JQIamo/LongTermTempMon/LongTermTempMon_4ch.brd

## EAGLE design LongTermTempMon_4ch.brd (2015-11-16)

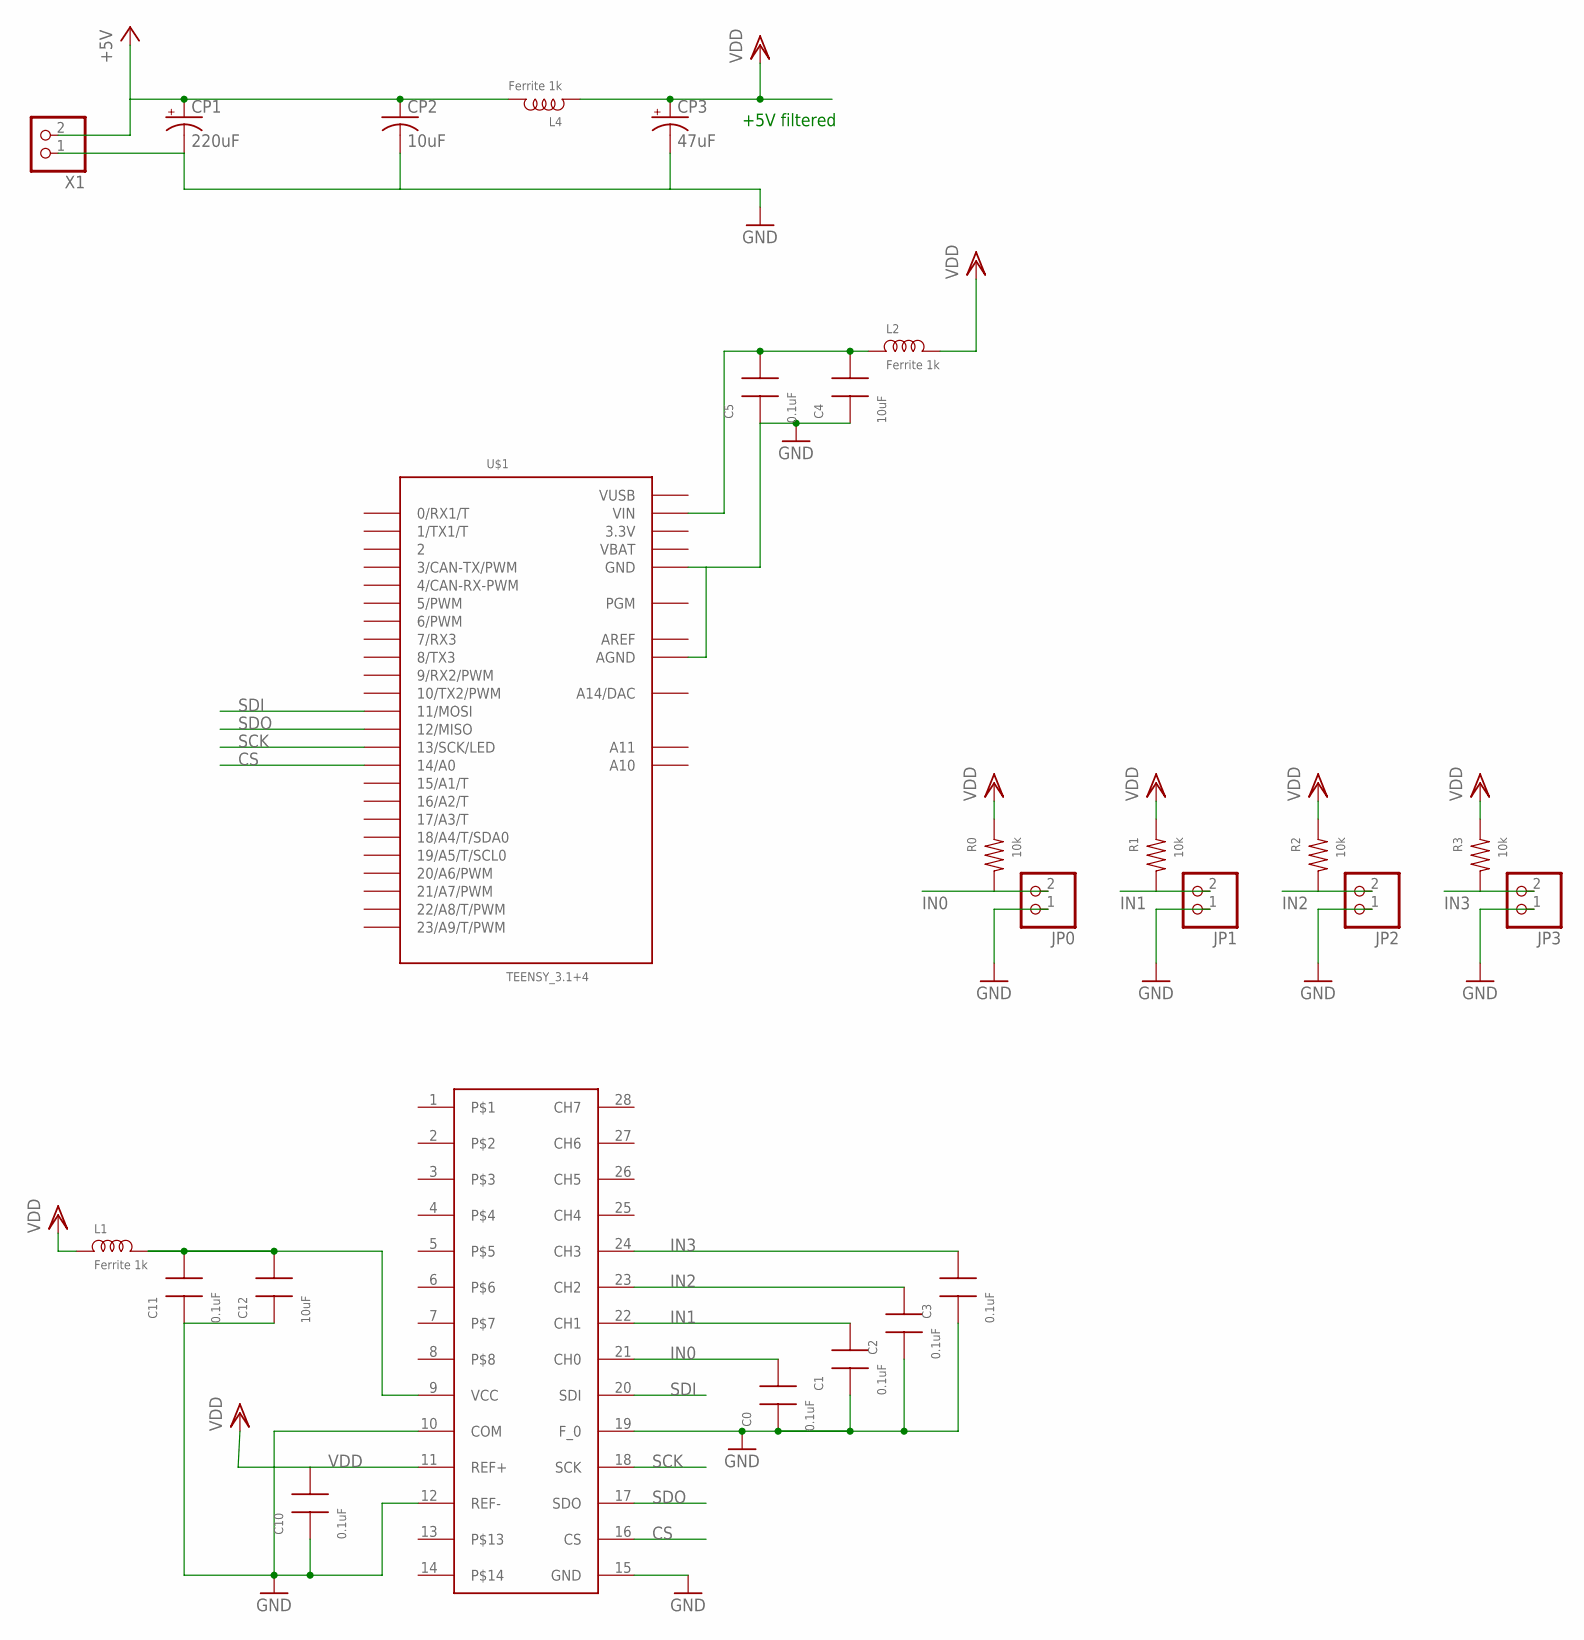
[picture p1: schematic LongTermTempMon_4ch.sch]

Parts:
C0, C1, C2, C3, C5, C10, C11: 0.1uF; 0603
C4, C12: 10uF; 0805
CP1: 220uF; PANASONIC_F
CP2: 10uF; C0805K
CP3: 47uF; CT7343
IC2: LTC2418; SSOP28
JP0, JP1, JP2, JP3: SCRWTRM-1X2; 1X02_SCRWTRM
L1, L2, L4: Ferrite 1k; 0805
R0, R1, R2, R3: 10k; 1206
U$1: TEENSY_3.1+4
X1: SCRWTRM-1X2; 1X02_SCRWTRM

Connections:
3.3V: U$1.3.3V, U$1.3.3V1 (3.3V)
+5V: CP1.+, CP2.1, L4.2, X1.2
AREF: U$1.AREF
CS: IC2.16 (CS), U$1.14/A0
GND: C0.1, C1.1, C2.1, C3.1, C4.1, C5.1, C10.1, C11.1, C12.1, CP1.-, CP2.2, CP3.-, IC2.10 (COM), IC2.12 (REF-), IC2.15 (GND), IC2.19 (F_0), JP0.1, JP1.1, JP2.1, JP3.1, U$1.AGND, U$1.GND, U$1.GND1 (GND), X1.1
IN0: C0.2, IC2.21 (CH0), JP0.2, R0.2
IN1: C1.2, IC2.22 (CH1), JP1.2, R1.2
IN2: C2.2, IC2.23 (CH2), JP2.2, R2.2
IN3: C3.2, IC2.24 (CH3), JP3.2, R3.2
unnamed: C11.2, C12.2, IC2.9 (VCC), L1.2
unnamed: C4.2, C5.2, L2.1, U$1.VIN
SCK: IC2.18 (SCK), U$1.13 (13/SCK/LED)
SDI: IC2.20 (SDI), U$1.11 (11/MOSI)
SDO: IC2.17 (SDO), U$1.12 (12/MISO)
VBAT: U$1.VBAT
VDD: C10.2, CP3.+, IC2.11 (REF+), L1.1, L2.2, L4.1, R0.1, R1.1, R2.1, R3.1
VUSB: U$1.VUSB

Notes on the sheet:
+5V filtered

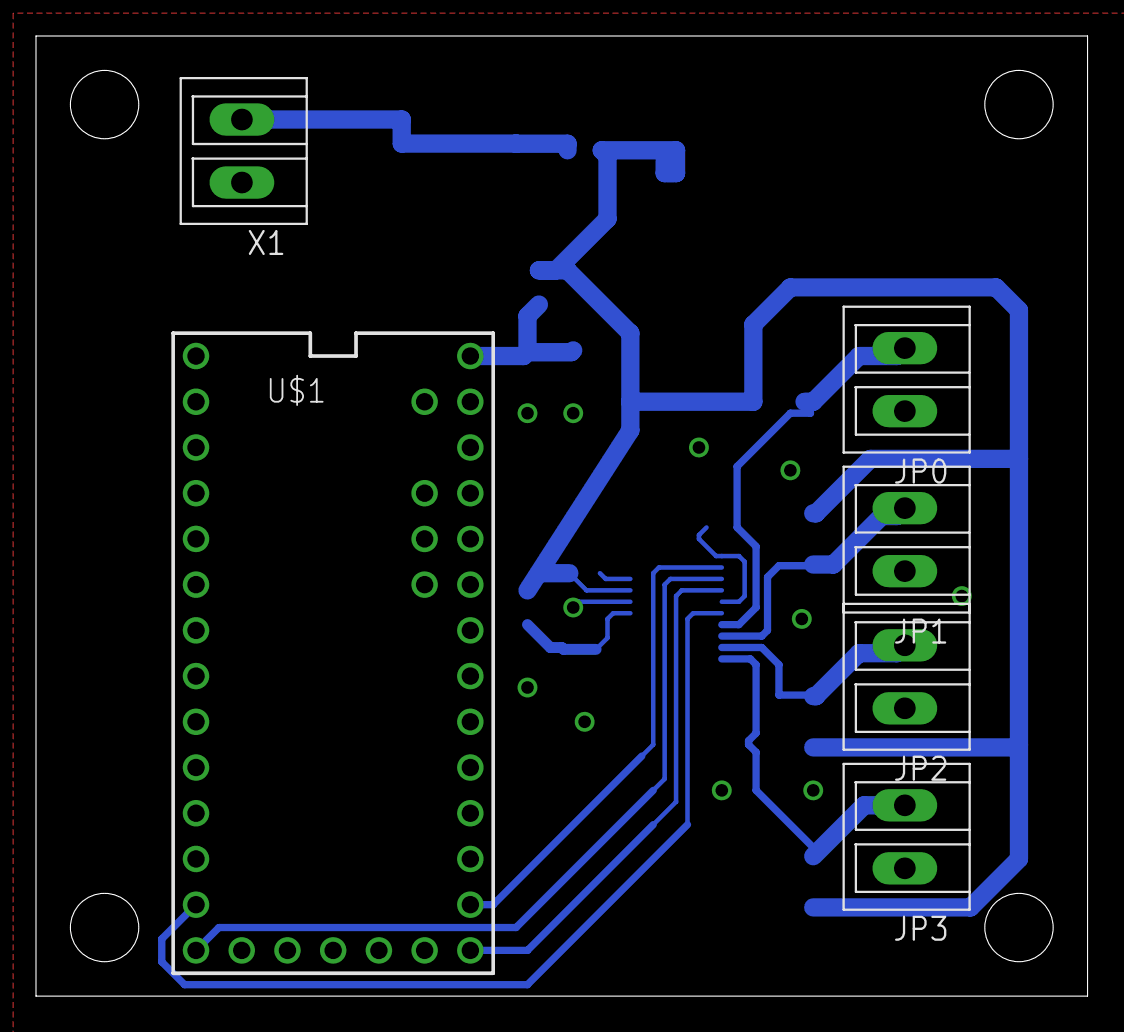
[picture p2: board LongTermTempMon_4ch.brd from above]

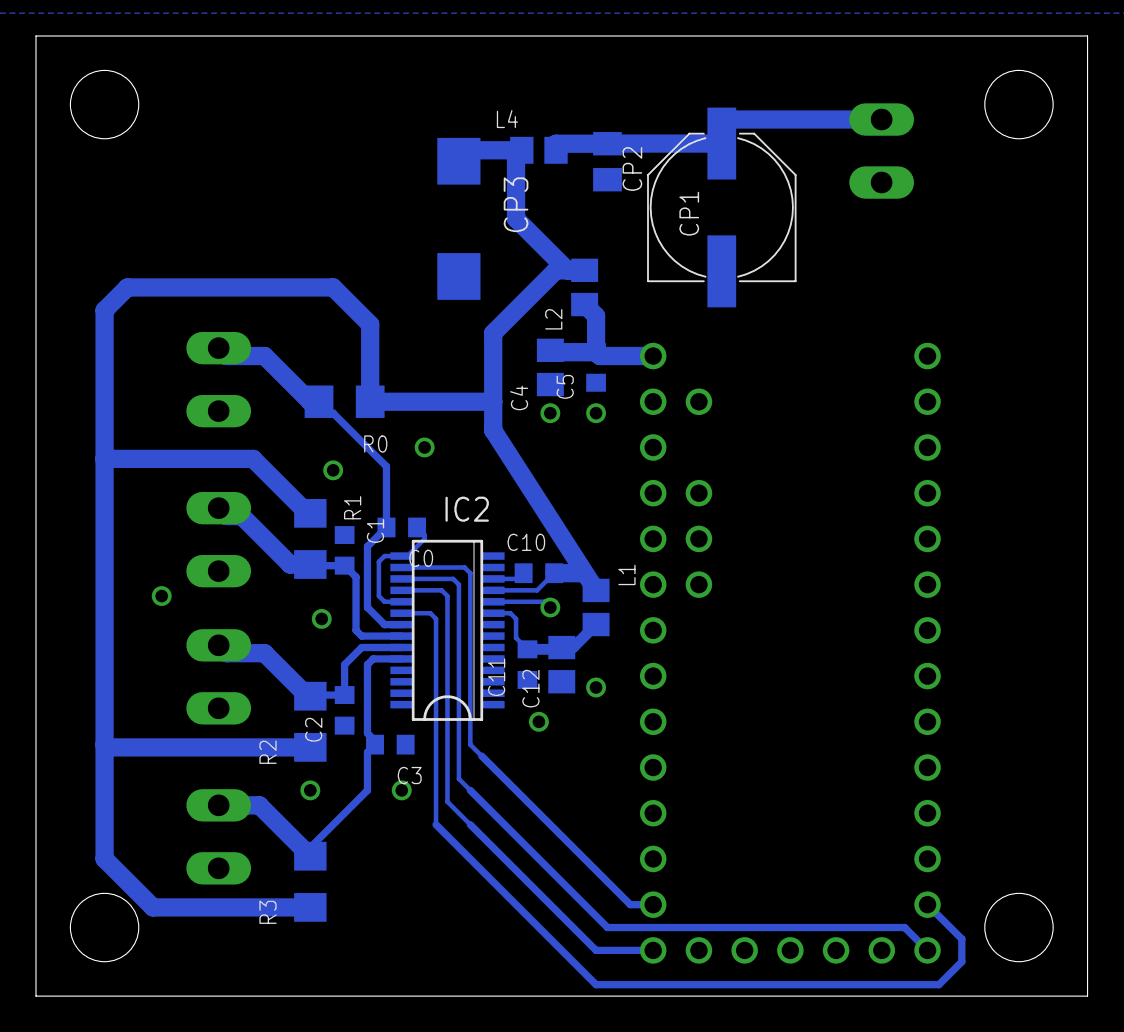
[picture p3: board LongTermTempMon_4ch.brd from below]

Board: 2 copper layers, 58.4 x 53.3 mm, 26 parts (20 on the bottom side), 14 nets.
