JQIamo/LongTermTempMon/LongTermTempMon.brd

## EAGLE design LongTermTempMon.brd (2015-11-16)

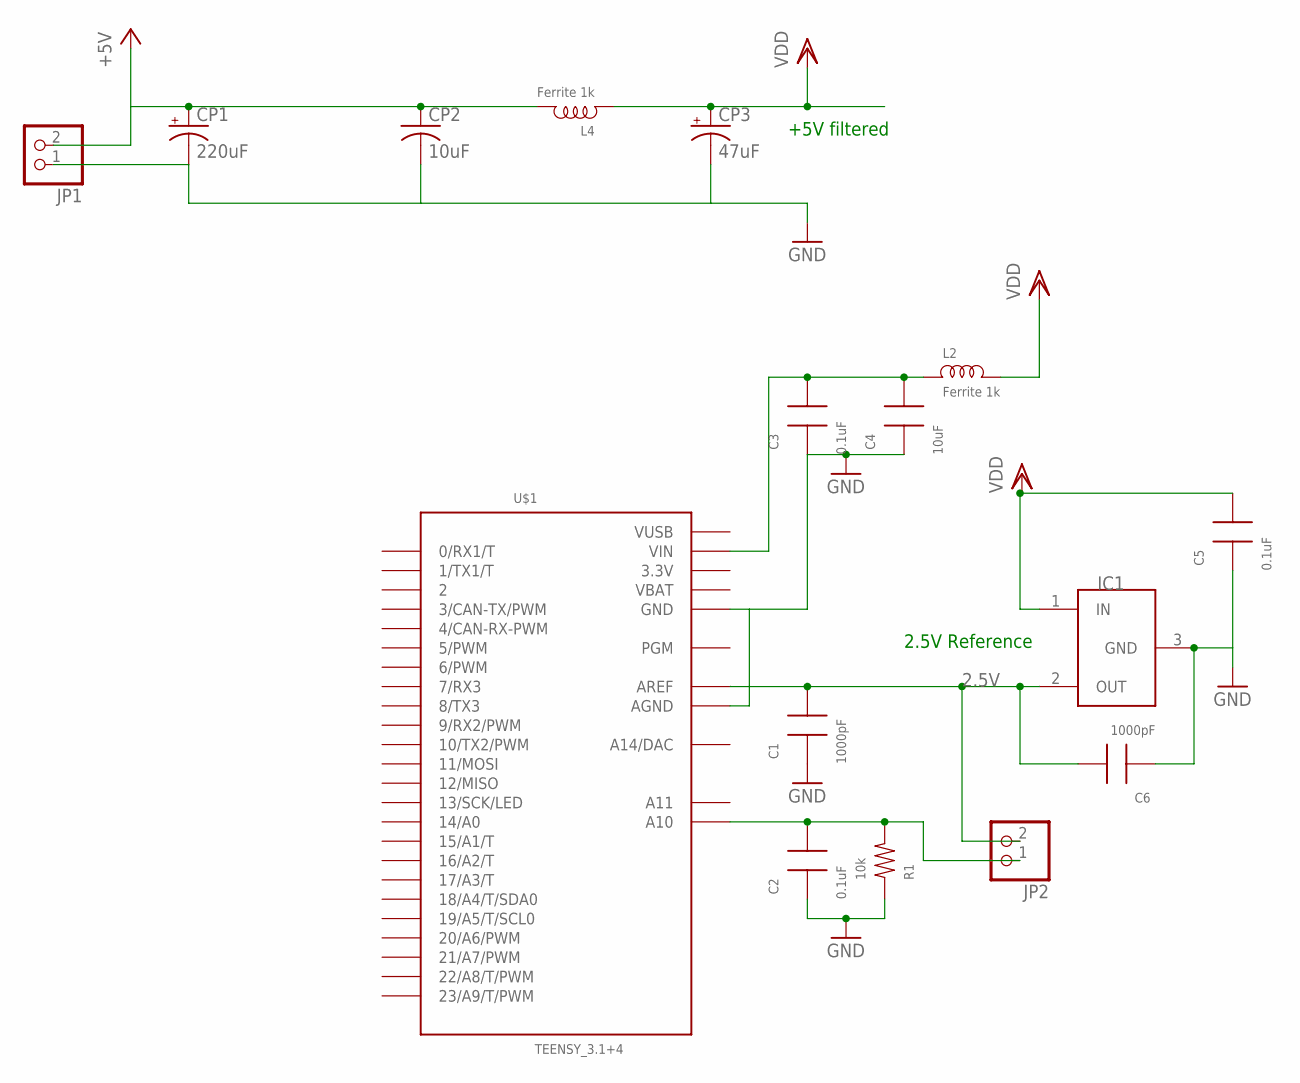
[picture p4: schematic LongTermTempMon.sch]

Parts:
C1, C6: 1000pF; 0603
C2, C3, C5: 0.1uF; 0603
C4: 10uF; 0805
CP1: 220uF; PANASONIC_F
CP2: 10uF; C0805K
CP3: 47uF; CT7343
IC1: TS6001; SOT-23
JP1, JP2: SCRWTRM-1X2; 1X02_SCRWTRM
L2, L4: Ferrite 1k; 0805
R1: 10k; 1206
U$1: TEENSY_3.1+4

Connections:
2.5V: C1.2, C6.2, IC1.2 (OUT), JP2.2, U$1.AREF
3.3V: U$1.3.3V, U$1.3.3V1 (3.3V)
+5V: CP1.+, CP2.1, JP1.2, L4.2
GND: C1.1, C2.1, C3.1, C4.1, C5.1, C6.1, CP1.-, CP2.2, CP3.-, IC1.3 (GND), JP1.1, R1.1, U$1.AGND, U$1.GND, U$1.GND1 (GND)
unnamed: C2.2, JP2.1, R1.2, U$1.A10
unnamed: C3.2, C4.2, L2.1, U$1.VIN
VBAT: U$1.VBAT
VDD: C5.2, CP3.+, IC1.1 (IN), L2.2, L4.1
VUSB: U$1.VUSB

Notes on the sheet:
2.5V Reference
+5V filtered

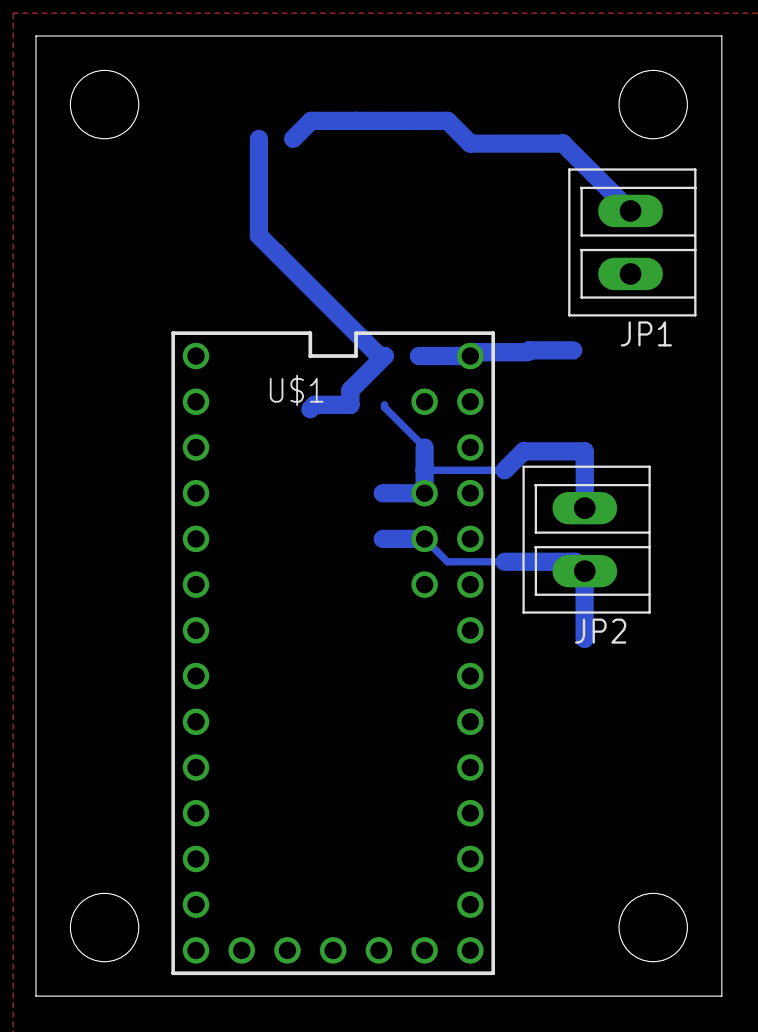
[picture p5: board LongTermTempMon.brd from above]

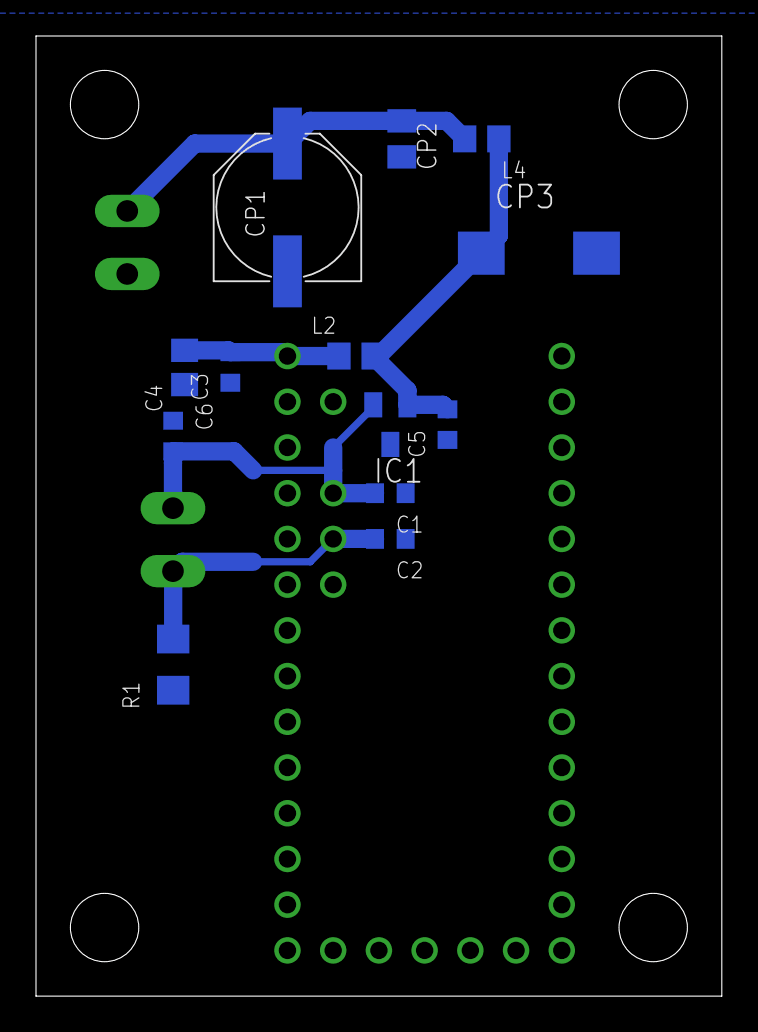
[picture p6: board LongTermTempMon.brd from below]

Board: 2 copper layers, 38.1 x 53.3 mm, 16 parts (13 on the bottom side), 7 nets.
