JQIamo/LongTermTempMon/(commit log)

2015-11-16 Single Channel, low res version
    Originoal version is just one channel and uses the internal ADC of the
    teensy
    [LongTermTempMon.brd, LongTermTempMon.sch]
2015-11-16 Add 4 channel, high res version
    This version has more channels (4, though could be more) and an external
    ADC chip (LTC2418) with 24 bit resolution and up to 16 channels)
    [LongTermTempMon_4ch.brd, LongTermTempMon_4ch.sch]
2015-11-16 Modified circuit to have reference resistor tied to +5V instead of Gnd
    [LongTermTempMon_4ch.brd, LongTermTempMon_4ch.sch]
2015-12-28 Start Arduino sketch
2015-12-29 Arduino code working, needs calibration
2015-12-30 Added function that correctly reads to commanded channel
    [LTC2418.cpp, LTC2418.h, LongTermTempMon.ino]
